hjohnson/SPI-RNG/SPI_RNG_BOM.xls

Digi-Key Part Number | Manufacturer | Manufacturer Part Number | Customer Reference | Quantity 1 | Quantity 2 | Quantity 3 | Description | Comments | RoHS Status | Lead Free Status | REACH Status
ZXRE1004FFCT-ND | DIODES/ZETEX (VA) | ZXRE1004FFTA |  | 1 | 10 | 100 | IC VREF SHUNT PREC 1.22V SOT23-3 | Alternate Packaging Exists | RoHS Compliant | Lead free | Unaffected Sep-2011
MMBT3904FSCT-ND | FAIRCHILD SEMICONDUCTOR (VA) | MMBT3904 |  | 1 | 10 | 100 | TRANSISTOR GP NPN AMP SOT-23 | Alternate Packaging Exists | RoHS Compliant | Lead free | Unaffected Jun-2011
ATTINY25-20SU-ND | ATMEL | ATTINY25-20SU |  | 1 | 10 | 100 | IC AVR MCU 2K 20MHZ 8-SOIC | Alternate Packaging Exists | RoHS Compliant | Lead free | Unaffected Sep-2011
296-17546-1-ND | TEXAS INSTRUMENTS (VA) | LP2981-30DBVR |  | 1 | 10 | 100 | IC LDO REG 3V 100MA SOT23-5 | Alternate Packaging Exists | RoHS Compliant | Lead free | Unaffected Jul-2011
490-5760-1-ND | MURATA ELECTRONICS (VA) | GRM219R61A105KA01D |  | 2 | 20 | 200 | CAP CER 1UF 10V 10% X5R 0805 | Alternate Packaging Exists | RoHS Compliant | Lead free | Not Available
RMCF0805JT10K0CT-ND | STACKPOLE ELECTRONICS INC (VA) | RMCF0805JT10K0 |  | 3 | 30 | 300 | RES 10K OHM 1/8W 5% 0805 SMD | Alternate Packaging Exists | RoHS Compliant | Lead free | Unaffected Aug-2011
RMCF0805JT100KCT-ND | STACKPOLE ELECTRONICS INC (VA) | RMCF0805JT100K |  | 1 | 10 | 100 | RES 100K OHM 1/8W 5% 0805 SMD | Alternate Packaging Exists | RoHS Compliant | Lead free | Unaffected Aug-2011
RMCF0805JT470RCT-ND | STACKPOLE ELECTRONICS INC (VA) | RMCF0805JT470R |  | 1 | 10 | 100 | RES 470 OHM 1/8W 5% 0805 SMD | Alternate Packaging Exists | RoHS Compliant | Lead free | Unaffected Aug-2011
RMCF0805JT1M00CT-ND | STACKPOLE ELECTRONICS INC (VA) | RMCF0805JT1M00 |  | 1 | 10 | 100 | RES 1M OHM 1/8W 5% 0805 SMD | Alternate Packaging Exists | RoHS Compliant | Lead free | Unaffected Aug-2011
MCP6282-E/SN-ND | MICROCHIP TECHNOLOGY | MCP6282-E/SN |  | 1 | 10 | 100 | IC OPAMP 2.2V DUAL R-R 8SOIC | Alternate Packaging Exists | RoHS Compliant | Lead free | Unaffected Dec-2011
WM6036-ND | MOLEX INC | 22-28-8360 |  | 1 | 10 | 100 | CONN HEADER 36POS .100 R/A TIN |  | RoHS Compliant | Lead free | Unaffected Dec-2009
