hjohnson/SPI-RNG/SPI_RNG_quote.xls

Digi-Key Part Number | Manufacturer | Manufacturer Part Number | Description | Customer Reference | Quantity 1 | Price | Quantity 2 | Price | Quantity 3 | Price | Stock Status | Comments | RoHS Status | Lead Free Status | REACH Status
ZXRE1004FFCT-ND | DIODES/ZETEX (VA) | ZXRE1004FFTA | IC VREF SHUNT PREC 1.22V SOT23-3 |  | 1 | 1.17 | 10 | 1.051 | 100 | 0.8343 | IN STOCK | Alternate Packaging Exists | RoHS Compliant | Lead free | Unaffected Sep-2011
MMBT3904FSCT-ND | FAIRCHILD SEMICONDUCTOR (VA) | MMBT3904 | TRANSISTOR GP NPN AMP SOT-23 |  | 1 | 0.16 | 10 | 0.149 | 100 | 0.0973 | IN STOCK | Alternate Packaging Exists | RoHS Compliant | Lead free | Unaffected Jun-2011
ATTINY25-20SU-ND | ATMEL | ATTINY25-20SU | IC AVR MCU 2K 20MHZ 8-SOIC |  | 1 | 0.95 | 10 | 0.95 | 100 | 0.528 | IN STOCK | Alternate Packaging Exists | RoHS Compliant | Lead free | Unaffected Sep-2011
296-17546-1-ND | TEXAS INSTRUMENTS (VA) | LP2981-30DBVR | IC LDO REG 3V 100MA SOT23-5 |  | 1 | 0.66 | 10 | 0.578 | 100 | 0.4448 | IN STOCK | Alternate Packaging Exists | RoHS Compliant | Lead free | Unaffected Jul-2011
490-5760-1-ND | MURATA ELECTRONICS (VA) | GRM219R61A105KA01D | CAP CER 1UF 10V 10% X5R 0805 |  | 2 | 0.07 | 20 | 0.061 | 200 | 0.0427 | IN STOCK | Alternate Packaging Exists | RoHS Compliant | Lead free | Not Available
RMCF0805JT10K0CT-ND | STACKPOLE ELECTRONICS INC (VA) | RMCF0805JT10K0 | RES 10K OHM 1/8W 5% 0805 SMD |  | 3 | 0.03 | 30 | 0.021 | 300 | 0.00652 | IN STOCK | Alternate Packaging Exists | RoHS Compliant | Lead free | Unaffected Aug-2011
RMCF0805JT100KCT-ND | STACKPOLE ELECTRONICS INC (VA) | RMCF0805JT100K | RES 100K OHM 1/8W 5% 0805 SMD |  | 1 | 0.03 | 10 | 0.021 | 100 | 0.0088 | IN STOCK | Alternate Packaging Exists | RoHS Compliant | Lead free | Unaffected Aug-2011
RMCF0805JT470RCT-ND | STACKPOLE ELECTRONICS INC (VA) | RMCF0805JT470R | RES 470 OHM 1/8W 5% 0805 SMD |  | 1 | 0.03 | 10 | 0.021 | 100 | 0.0088 | IN STOCK | Alternate Packaging Exists | RoHS Compliant | Lead free | Unaffected Aug-2011
RMCF0805JT1M00CT-ND | STACKPOLE ELECTRONICS INC (VA) | RMCF0805JT1M00 | RES 1M OHM 1/8W 5% 0805 SMD |  | 1 | 0.03 | 10 | 0.021 | 100 | 0.0088 | IN STOCK | Alternate Packaging Exists | RoHS Compliant | Lead free | Unaffected Aug-2011
MCP6282-E/SN-ND | MICROCHIP TECHNOLOGY | MCP6282-E/SN | IC OPAMP 2.2V DUAL R-R 8SOIC |  | 1 | 0.96 | 10 | 0.8 | 100 | 0.6 | IN STOCK | Alternate Packaging Exists | RoHS Compliant | Lead free | Unaffected Dec-2011
WM6036-ND | MOLEX INC | 22-28-8360 | CONN HEADER 36POS .100 R/A TIN |  | 1 | 1.43 | 10 | 1.191 | 100 | 0.8822 | IN STOCK |  | RoHS Compliant | Lead free | Unaffected Dec-2009
Total Price |  |  |  |  |  | 5.65 |  | 49.67 |  | 351.796
Unit Price |  |  |  |  |  | 5.65 |  | 4.967 |  | 3.51796
