hjohnson/SPI-RNG/random_generator_2.brd

## EAGLE design random_generator_2.brd (2012-04-19)

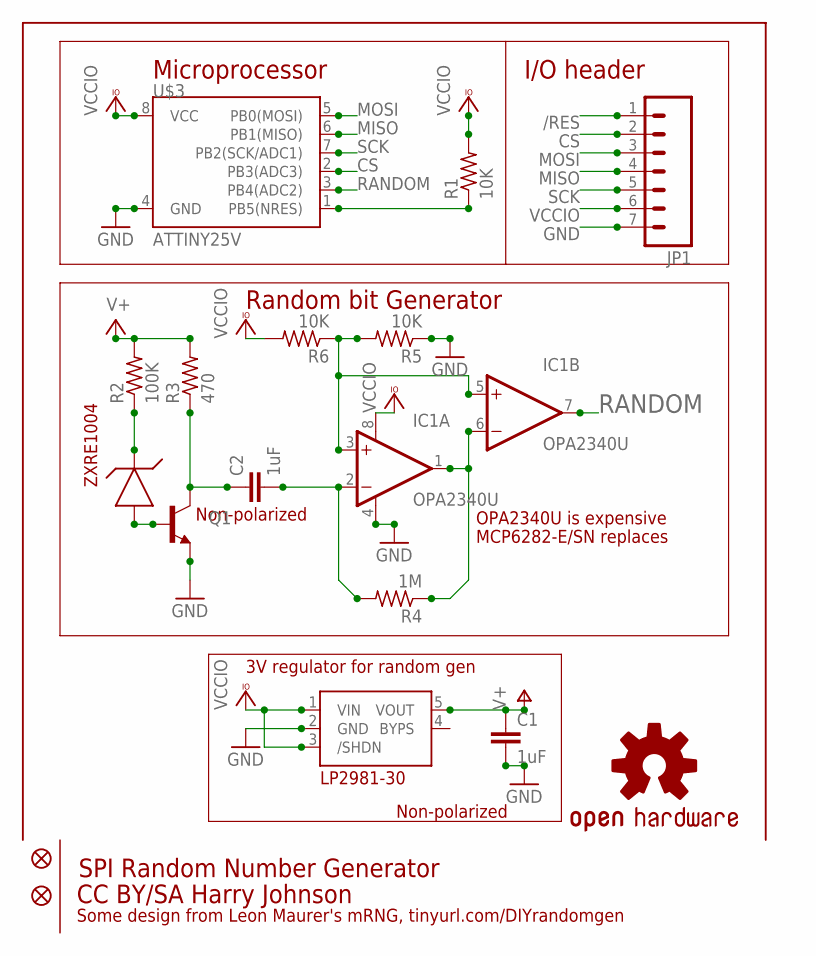
[picture p1: schematic random_generator_2.sch]

Parts:
C1, C2: 1uF; 0805
IC1: OPA2340U; SO08
JP1: M07; 1X07
JP2, JP3: FIDUCIALUFIDUCIAL; MICRO-FIDUCIAL
Q1: TRANSISTOR_NPNSOT23; SOT23
R1, R5, R6: 10K; R0805
R2: 100K; R0805
R3: 470; R0805
R4: 1M; R0805
U$1: ZXRE1004FFTA; SOT23
U$2: TC1014; SOT23-5L
U$3: ATTINY25V; SO08-EIAJ
U$4: OSHW-LOGOS; OSHW-LOGO-S

Connections:
/RES: JP1.1, R1.1, U$3.1 (PB5(NRES))
CS: JP1.2, U$3.2 (PB3(ADC3))
GND: C1.2, IC1.4 (V-), JP1.7, Q1.2 (E), R5.1, U$2.2 (GND), U$3.4 (GND)
MISO: JP1.4, U$3.6 (PB1(MISO))
MOSI: JP1.3, U$3.5 (PB0(MOSI))
unnamed: Q1.1 (B), U$1.2 (A)
unnamed: C2.1, Q1.3 (C), R3.1
unnamed: R2.1, U$1.1 (K)
unnamed: C2.2, IC1.2 (-IN), R4.2
unnamed: IC1.1 (OUT), IC1.6 (-IN), R4.1
unnamed: IC1.3 (+IN), IC1.5 (+IN), R5.2, R6.1
RANDOM: IC1.7 (OUT), U$3.3 (PB4(ADC2))
SCK: JP1.5, U$3.7 (PB2(SCK/ADC1))
V+: C1.1, R2.2, R3.2, U$2.5 (VOUT)
VCCIO: IC1.8 (V+), JP1.6, R1.2, R6.2, U$2.1 (VIN), U$2.3 (/SHDN), U$3.8 (VCC)

Notes on the sheet:
Random bit Generator
ZXRE1004
3V regulator for random gen
Microprocessor
I/O header
SPI Random Number Generator
CC BY/SA Harry Johnson
Some design from Leon Maurer's mRNG, tinyurl.com/DIYrandomgen
LP2981-30
OPA2340U is expensive
MCP6282-E/SN replaces
Non-polarized

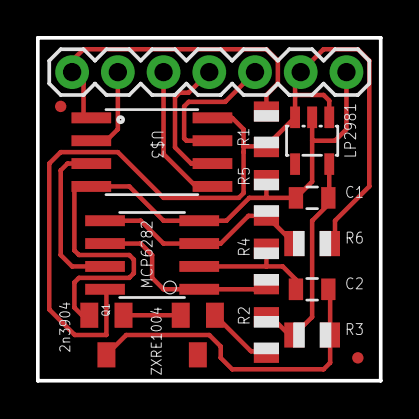
[picture p2: board random_generator_2.brd from above]

Board: 2 copper layers, 19.1 x 19.1 mm, 17 parts (1 on the bottom side), 15 nets.
