hjohnson/SPI-RNG/random_read/results/200K_random_hist.jpg

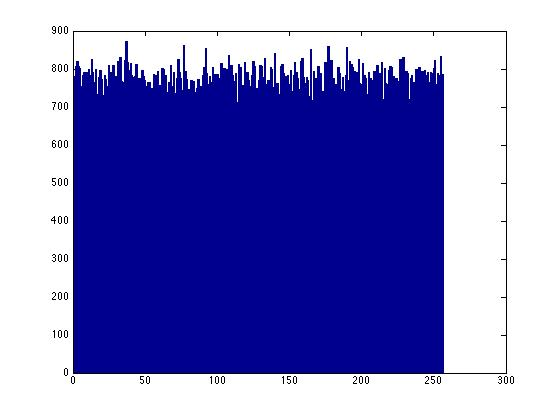
random_read/results/200K_random_hist.jpg
