hjohnson/SPI-RNG/(commit log)

2012-03-04 SPI RNG: SPI accessible RNG board.
    Small (.75" x .75") Random Number Generator, accessible via SPI. Would
    I trust it for crypto? No, not really, not yet. Is it still cool? Yes,
    I believe so. OSHW: Schematic, board, firmware, and BOM/quote files.
    [SPI_RNG_BOM.xls, SPI_RNG_quote.xls, random_generator_2.brd, random_generator_2.sch]
2012-04-17 MANY BUGS! NOW, HANDLE IT!
    A whole nightmarish mess of bugs fixed: Dr Nyquist prescribed some
    faster sampling, (just in case). I also tied op amp to VCCIO instead of
    3V (for voltage swings guaranteed to trigger logic high), SPI/USI code
    now works too. WIll upload an Arduino test program soon…
    [random_generator_2.brd, random_generator_2.sch]
2012-04-17 Updates to BOM/Quote, and slight update to board: tweaked everything around a bit to give easier PnP placement
    [SPI_RNG_BOM.xls, SPI_RNG_quote.xls, random_generator_2.brd]
2012-04-18 Added a subdirectory: random_read. This is an Arduino program I used to test the RNG, as well as an example of its results (200K random numbers) and a histogram of said results.
2012-04-18 Revert "Added a subdirectory: random_read. This is an Arduino program I used to test the RNG, as well as an example of its results (200K random numbers) and a histogram of said results."
    This reverts commit 813bcb698b103c1f062770043ea5ba36d0701cd2.
    [random_read.ino]
2012-04-18 Revert "Revert "Added a subdirectory: random_read. This is an Arduino program I used to test the RNG, as well as an example of its results (200K random numbers) and a histogram of said results.""
    This reverts commit e8bffbb2eab26593f465c9e83c66a3b4be4fae53.
    [random_read.ino]
2012-04-19 Added/fixed comments in firmware, made component designators a bit bigger.
    [random_generator_2.brd, random_generator_2.sch]
