hjohnson/SPI-RNG/(notices)

Notices in the files:
random_generator_2.brd:
CC BY/SA HMJ
parts and their libraries:
SparkFun: Licensing: CC v3.0 Share-Alike You are welcome to use this library for commercial purposes.
